ChrisOakes94/Nixie-Tube-Clock/Electrical/Nixie Tube Control Board/Other/Schematic.pdf

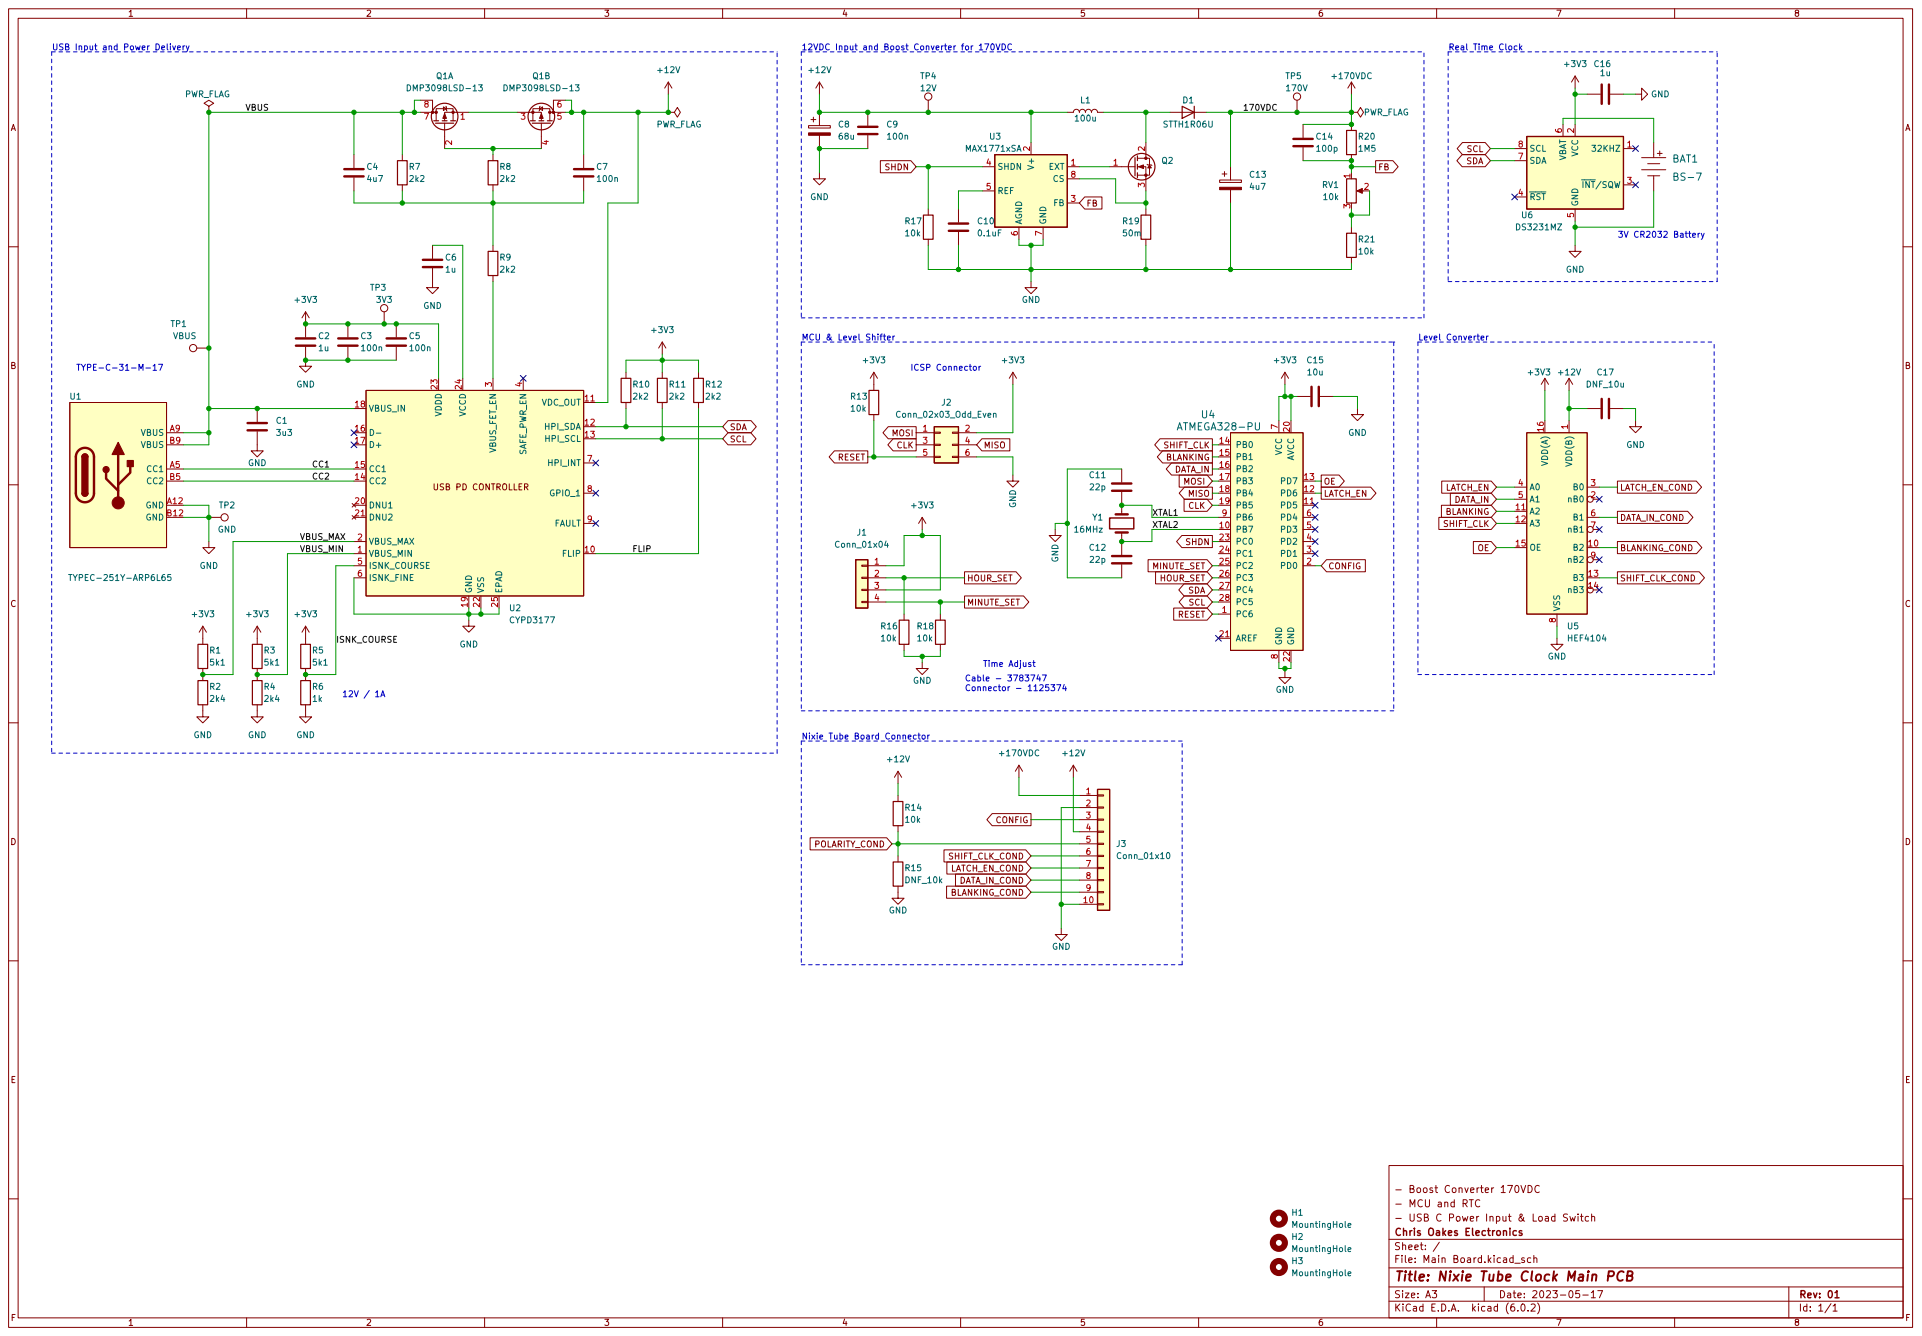
[picture p1: page 1]

2 ~{INT}/SQW 3 ~{RST} 4 GND

2 FB 3 SHDN 4 REF 5 AGND

- Boost Converter 170VDC
- MCU and RTC
- USB C Power Input & Load Switch
File: Main Board.kicad_sch Sheet: / Chris Oakes Electronics

Id: 1/1 Title: Nixie Tube Clock Main PCB
