ChrisOakes94/Nixie-Tube-Clock/Electrical/Nixie Tube Interface Board/Other/Schematic.pdf

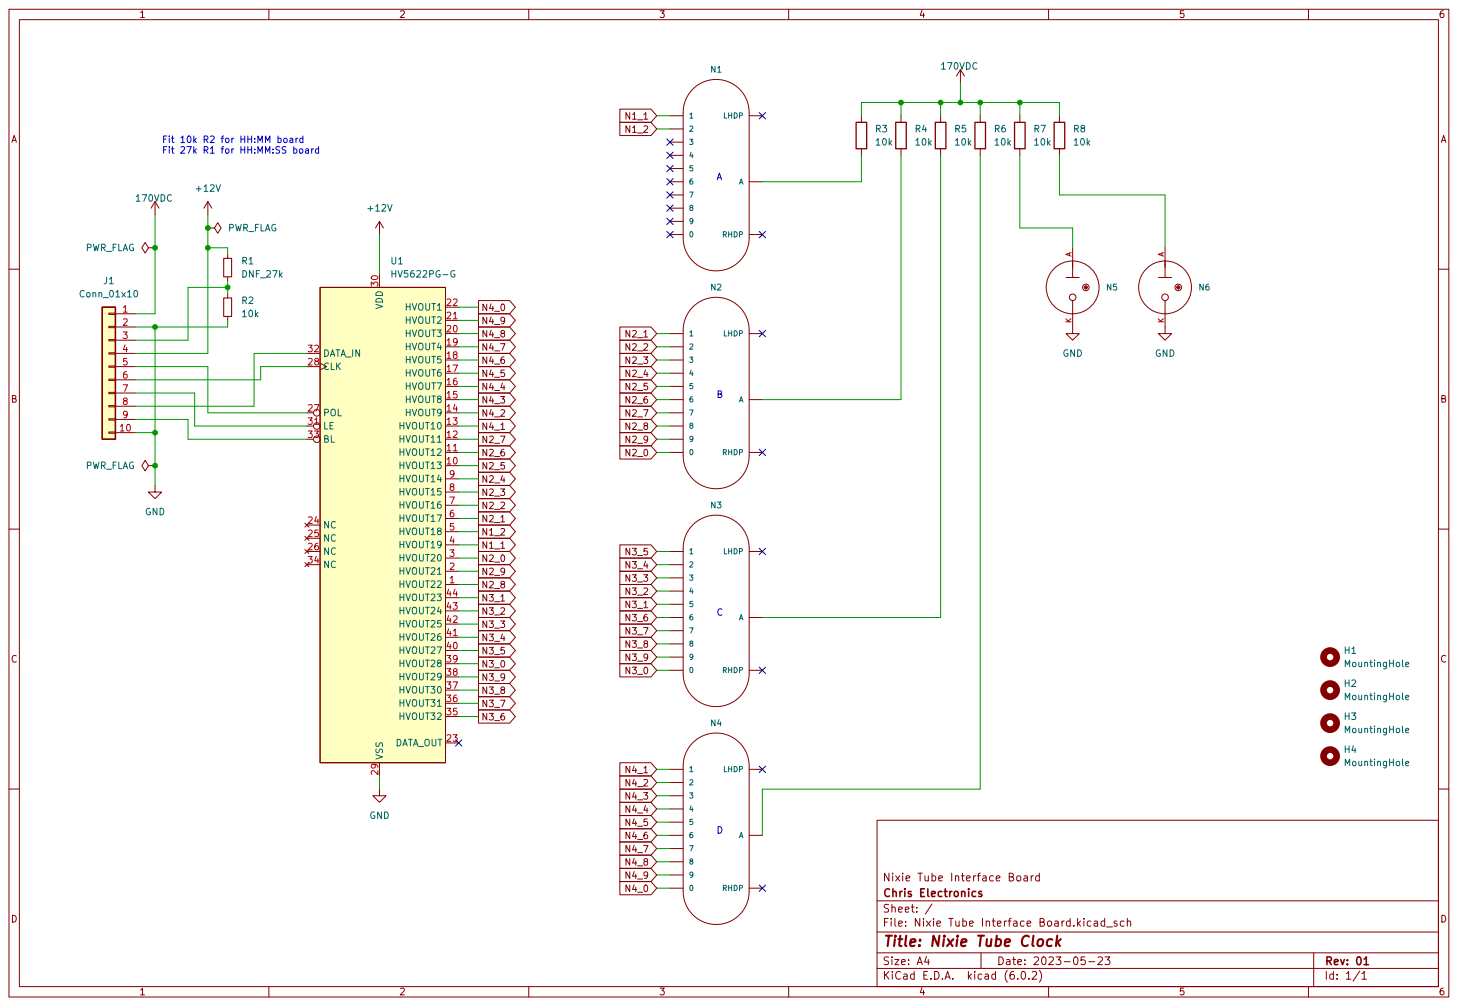
[picture p2: page 1]

Fit 10k R2 for HH:MM board Fit 27k R1 for HH:MM:SS board

Id: 1/1 Title: Nixie Tube Clock
