ChrisOakes94/Nixie-Tube-Clock/Electrical/Nixie Tube Control Board/Other/Drawing.pdf

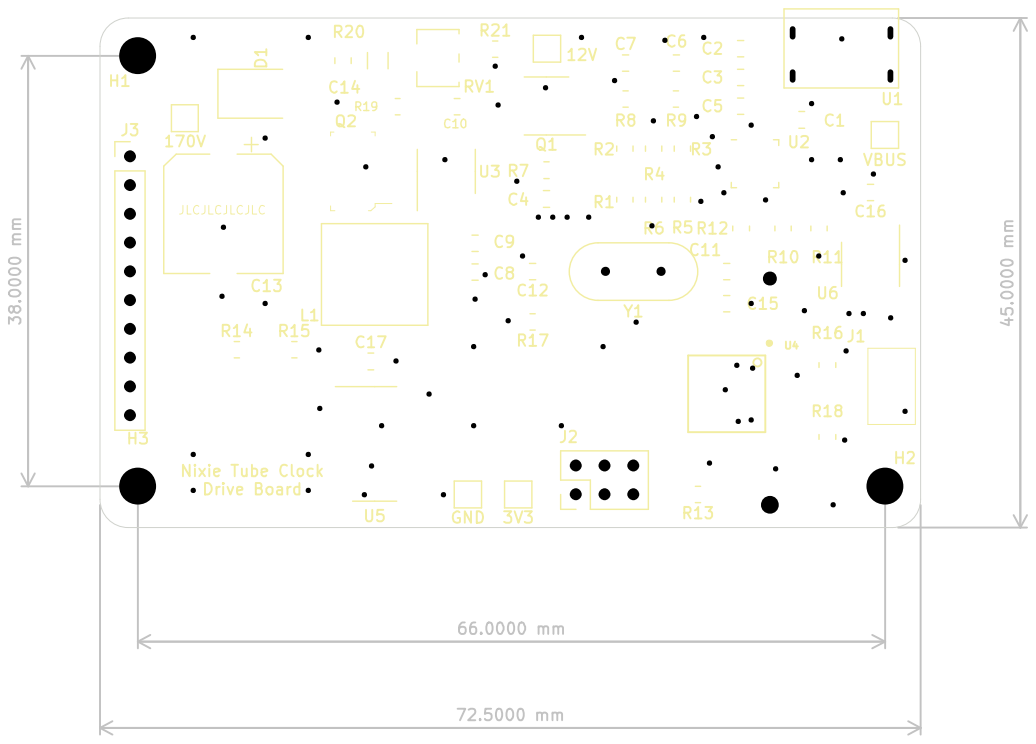
[picture p3: page 1]
