ChrisOakes94/Nixie-Tube-Clock/Electrical/Nixie Tube Interface Board/Other/Drawing.pdf

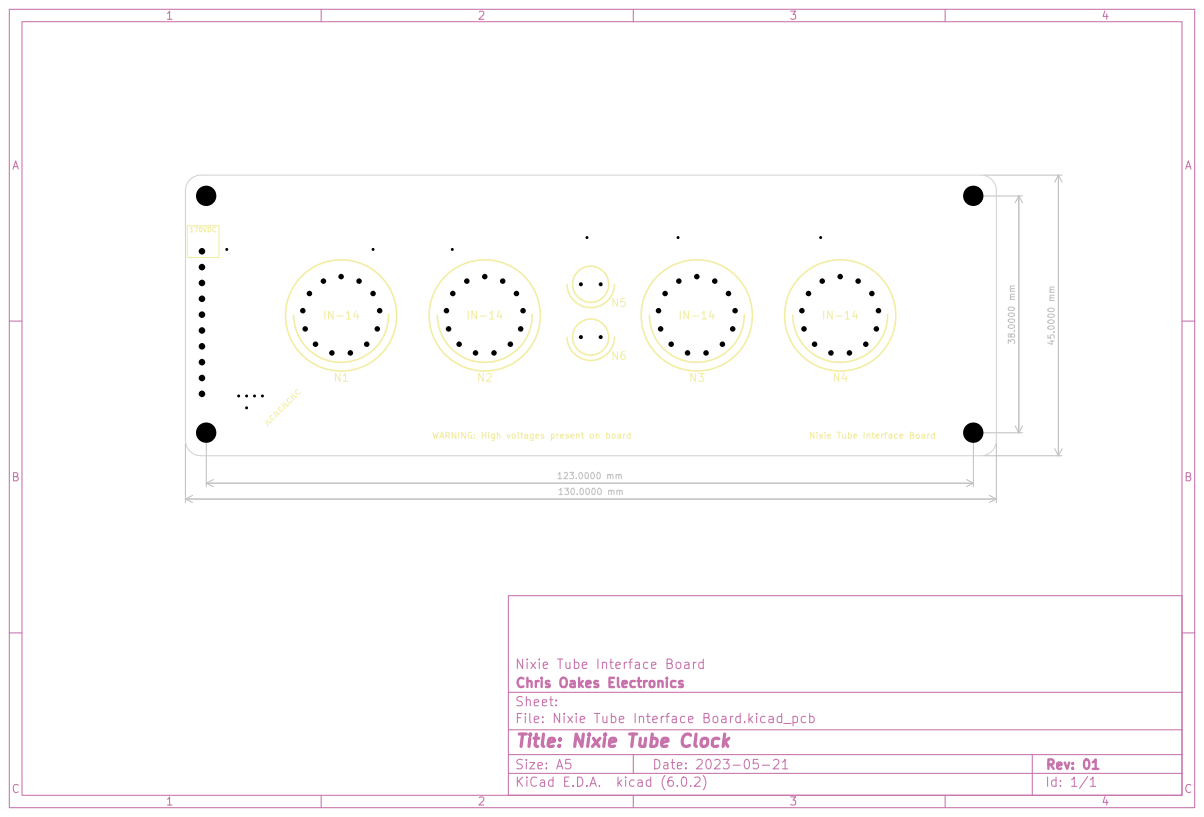
[picture p4: page 1]
