ChrisOakes94/Nixie-Tube-Clock/Electrical/Nixie Tube Interface Board/Nixie Tube Interface Board.kicad_pcb

## KiCad design Electrical/Nixie Tube Interface Board/Nixie Tube Interface Board.kicad_pcb (2023-05-26)

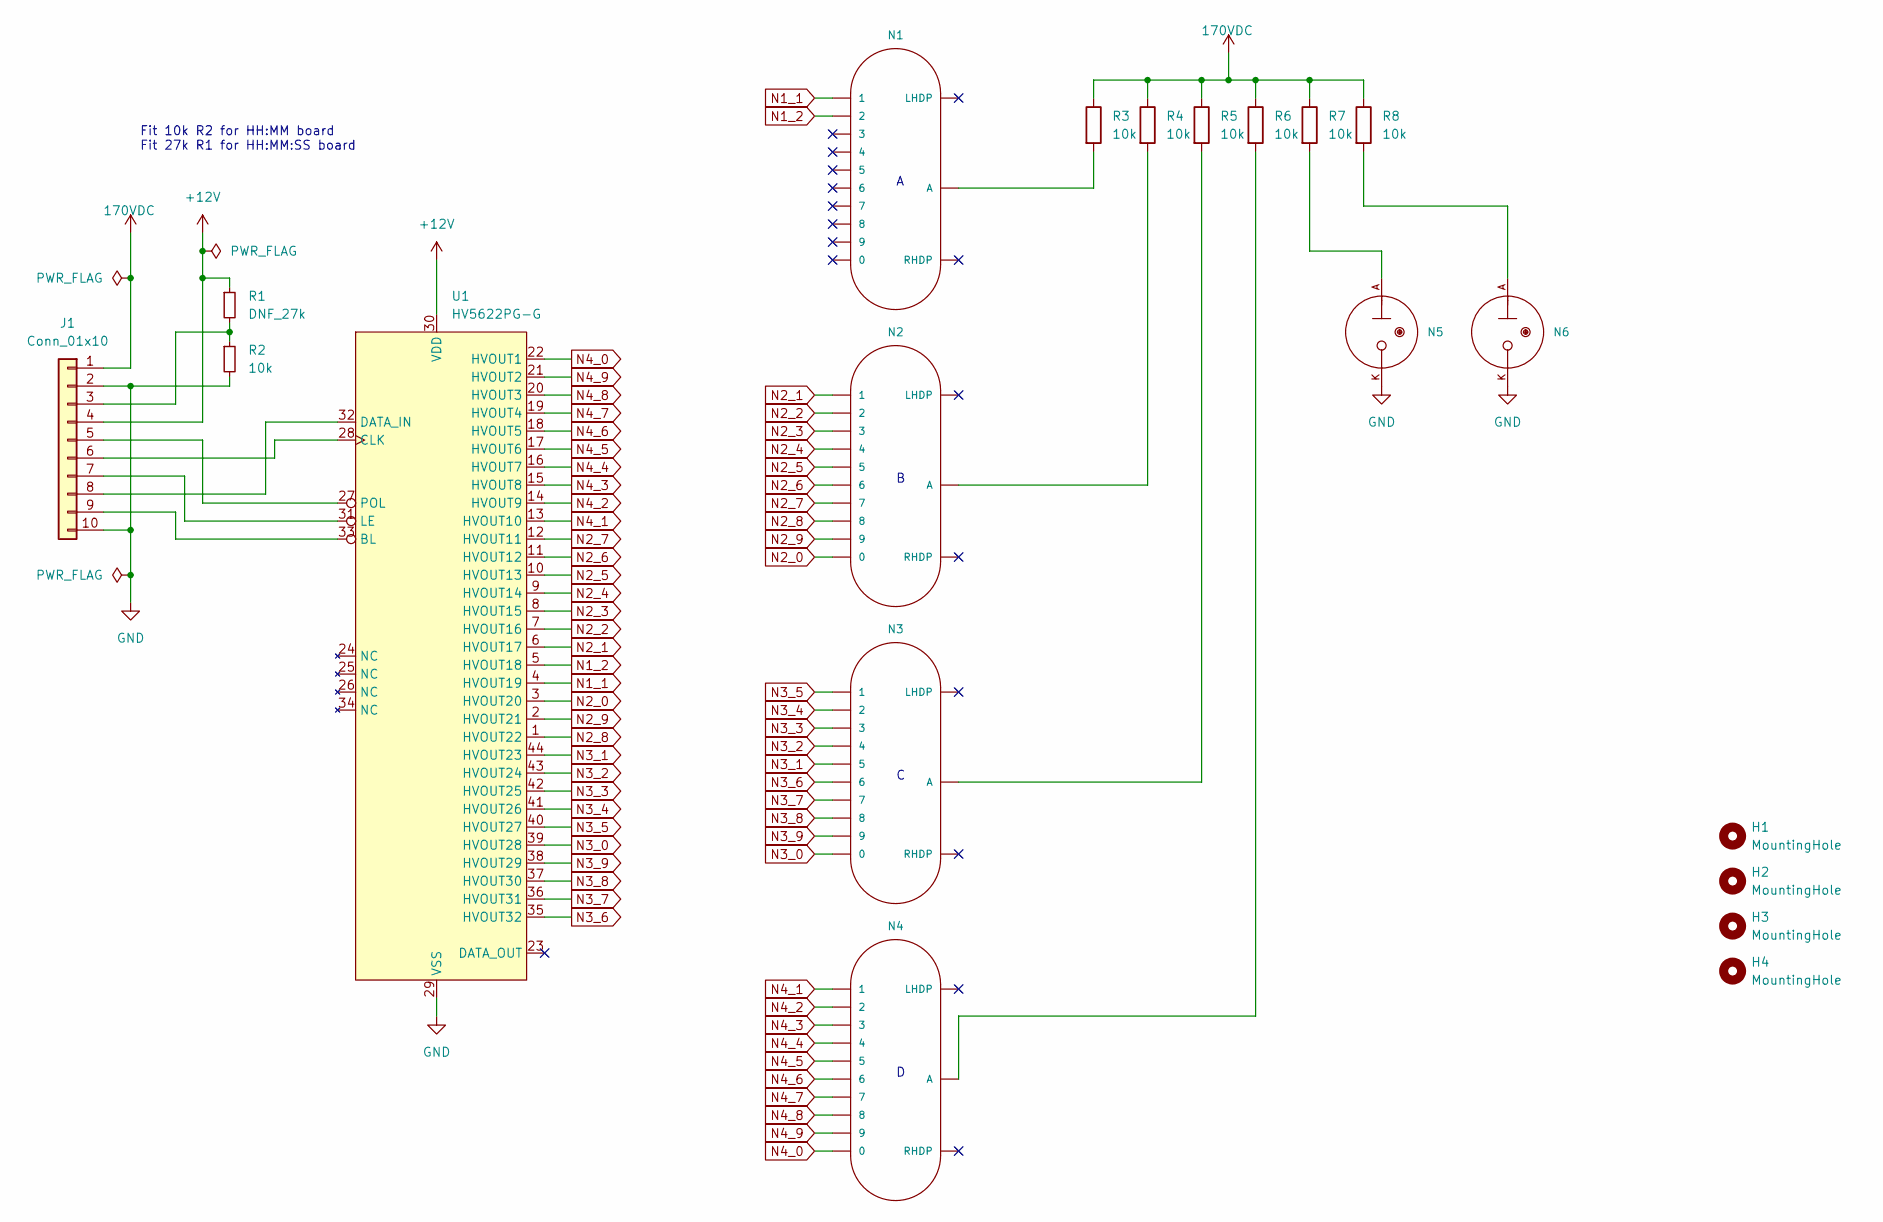
[picture p5: schematic Nixie Tube Interface Board.kicad_sch, Nixie Tube Clock]

Parts:
H1, H2, H3, H4: MountingHole; MountingHole_3.2mm_M3
J1: Conn_01x10; PinSocket_1x10_P2.54mm_Vertical
N1, N2, N3, N4: IN-14; nixies-us-IN-14
N5, N6: IN-3; nixies-us-IN-3
R1: DNF_27k; R_1206_3216Metric_Pad1.30x1.75mm_HandSolder
R2, R3, R4, R5, R6, R7, R8: 10k; R_1206_3216Metric_Pad1.30x1.75mm_HandSolder
U1: HV5622PG-G; LQFP-44_10x10mm_P0.8mm

Connections:
+12V: J1.4, R1.1, U1.30 (VDD)
+170VDC: J1.1, R3.1, R4.1, R5.1, R6.1, R7.1, R8.1
GND: J1.2, J1.10, N5.K, N6.K, R2.2, U1.29 (VSS)
N1_1: N1.1, U1.4 (HVOUT19)
N1_2: N1.2, U1.5 (HVOUT18)
N2_0: N2.0, U1.3 (HVOUT20)
N2_1: N2.1, U1.6 (HVOUT17)
N2_2: N2.2, U1.7 (HVOUT16)
N2_3: N2.3, U1.8 (HVOUT15)
N2_4: N2.4, U1.9 (HVOUT14)
N2_5: N2.5, U1.10 (HVOUT13)
N2_6: N2.6, U1.11 (HVOUT12)
N2_7: N2.7, U1.12 (HVOUT11)
N2_8: N2.8, U1.1 (HVOUT22)
N2_9: N2.9, U1.2 (HVOUT21)
N3_0: N3.0, U1.39 (HVOUT28)
N3_1: N3.5, U1.44 (HVOUT23)
N3_2: N3.4, U1.43 (HVOUT24)
N3_3: N3.3, U1.42 (HVOUT25)
N3_4: N3.2, U1.41 (HVOUT26)
N3_5: N3.1, U1.40 (HVOUT27)
N3_6: N3.6, U1.35 (HVOUT32)
N3_7: N3.7, U1.36 (HVOUT31)
N3_8: N3.8, U1.37 (HVOUT30)
N3_9: N3.9, U1.38 (HVOUT29)
N4_0: N4.0, U1.22 (HVOUT1)
N4_1: N4.1, U1.13 (HVOUT10)
N4_2: N4.2, U1.14 (HVOUT9)
N4_3: N4.3, U1.15 (HVOUT8)
N4_4: N4.4, U1.16 (HVOUT7)
N4_5: N4.5, U1.17 (HVOUT6)
N4_6: N4.6, U1.18 (HVOUT5)
N4_7: N4.7, U1.19 (HVOUT4)
N4_8: N4.8, U1.20 (HVOUT3)
N4_9: N4.9, U1.21 (HVOUT2)
unnamed: J1.3, R1.2, R2.1
unnamed: J1.5, U1.27 (POL)
unnamed: J1.6, U1.28 (CLK)
unnamed: J1.7, U1.31 (LE)
unnamed: J1.8, U1.32 (DATA_IN)
unnamed: J1.9, U1.33 (BL)
unnamed: N1.A, R3.2
unnamed: N2.A, R4.2
unnamed: N3.A, R5.2
unnamed: N4.A, R6.2
unnamed: N5.A, R7.2
unnamed: N6.A, R8.2

Notes on the sheet:
Fit 10k R2 for HH:MM board Fit 27k R1 for HH:MM:SS board

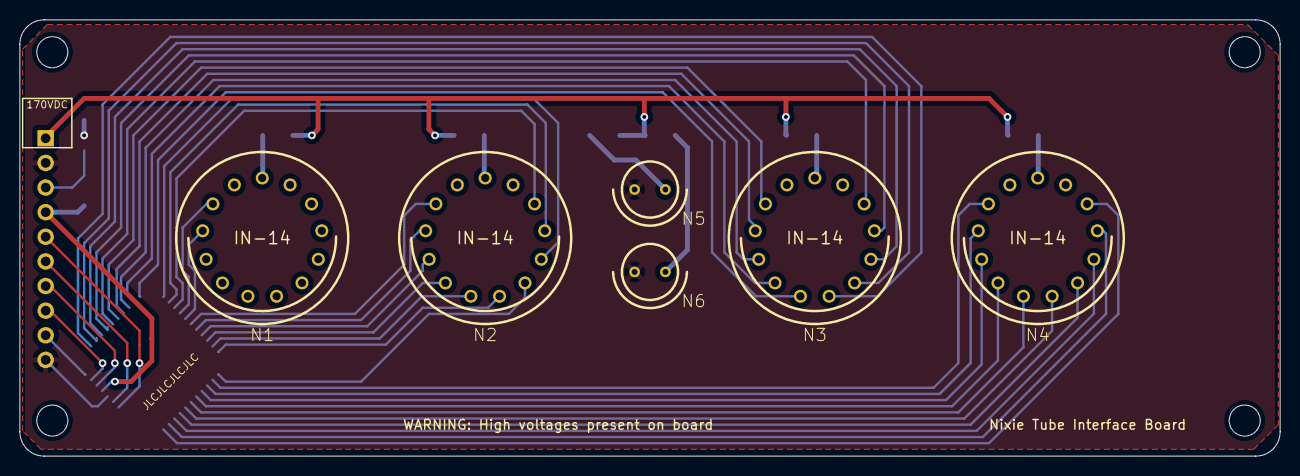
[picture p6: board Nixie Tube Interface Board.kicad_pcb from above]

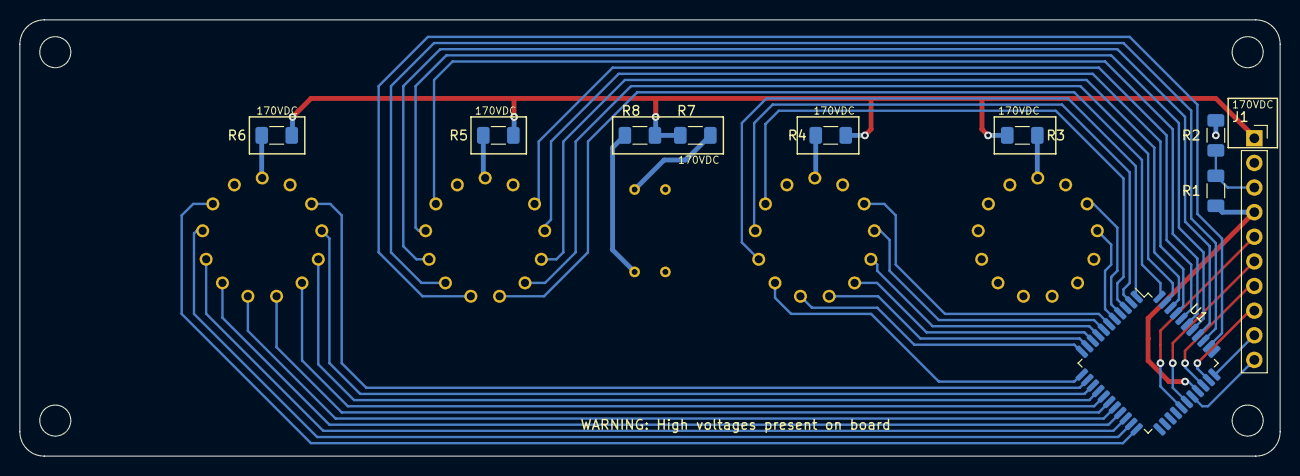
[picture p7: board Nixie Tube Interface Board.kicad_pcb from below]

Board: 2 copper layers, 130.0 x 45.0 mm, 20 parts (10 on the bottom side), 47 nets.
