ChrisOakes94/Nixie-Tube-Clock/Electrical/Nixie Tube Control Board/Main Board.kicad_pcb

## KiCad design Electrical/Nixie Tube Control Board/Main Board.kicad_pcb (2023-05-26)

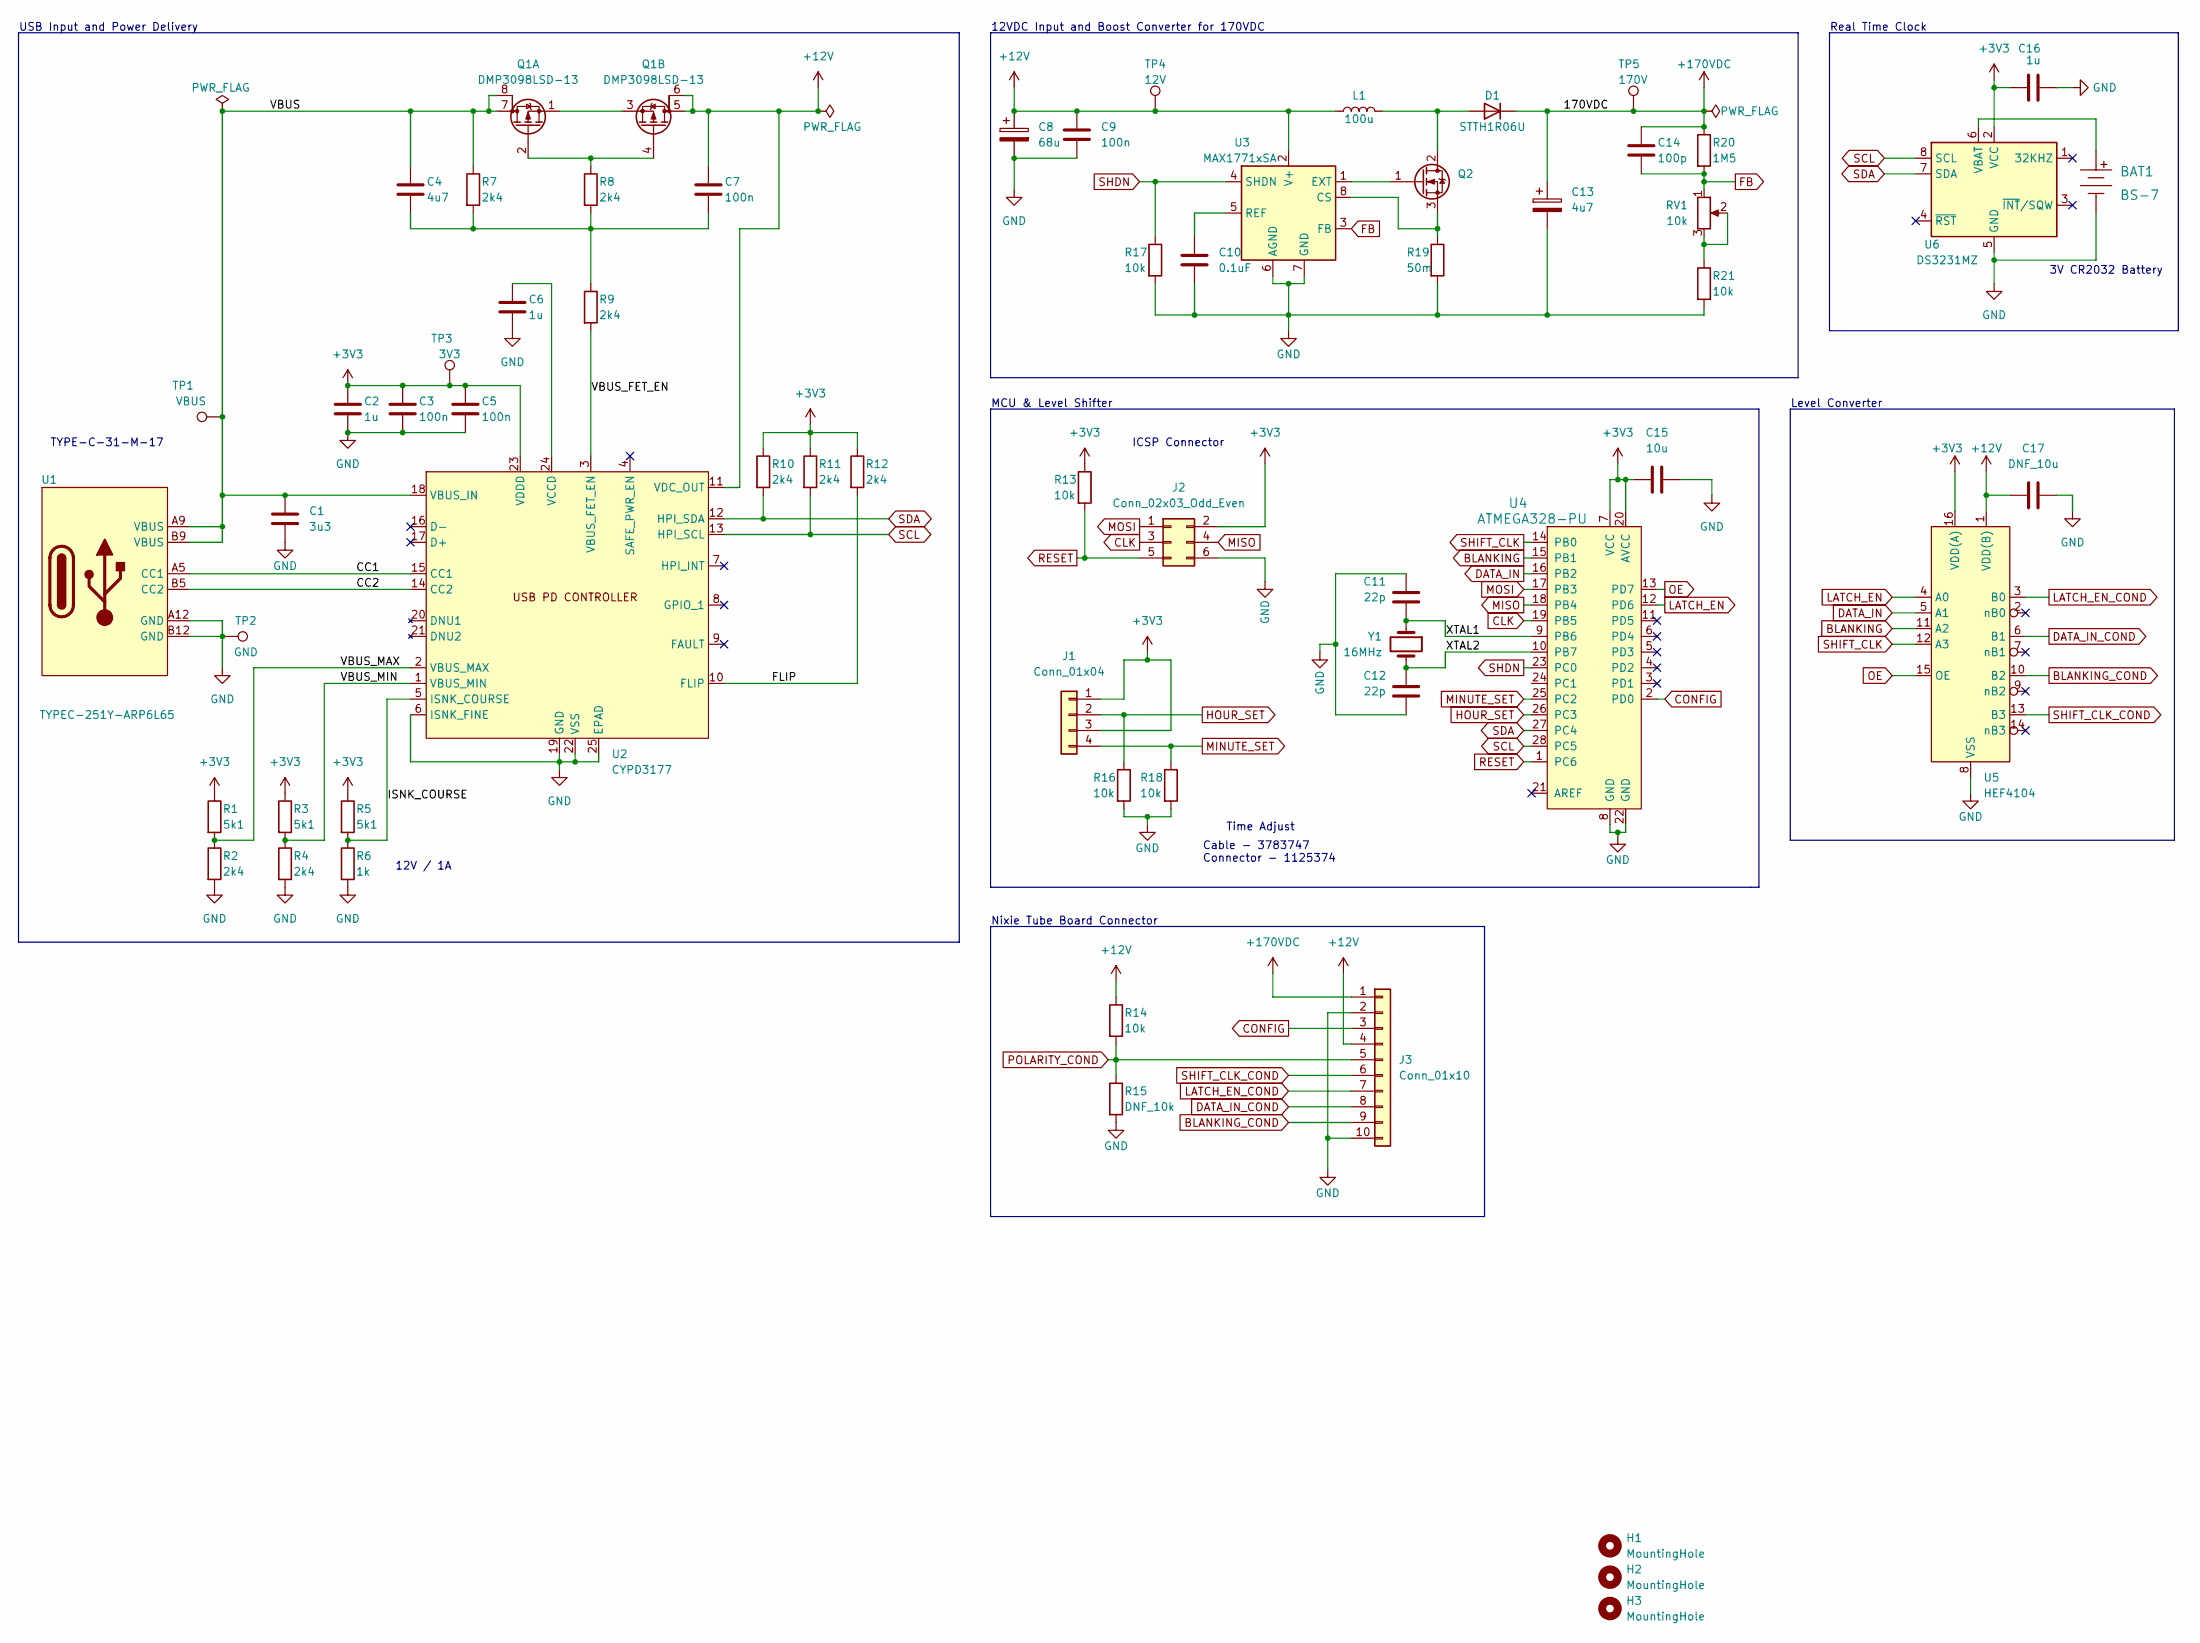
[picture p8: schematic Main Board.kicad_sch, Nixie Tube Clock Main PCB]

Parts:
BAT1: BS-7; Battery_Holder_Coin_2032_BS-7; MPN BS-7; Digi-Key_PN BS-7-ND
C1: 3u3; C_0805_2012Metric
C2, C6, C16: 1u; C_0805_2012Metric
C3, C5, C7, C9: 100n; C_0805_2012Metric
C4: 4u7; C_0805_2012Metric
C8: 68u; C_0805_2012Metric
C10: 0.1uF; C_0805_2012Metric
C11, C12: 22p; C_0805_2012Metric
C13: 4u7; CP_Elec_10x7.7; JLC P/N C2982253
C14: 100p; C_0805_2012Metric
C15: 10u; C_0805_2012Metric
C17: DNF_10u; C_0805_2012Metric
D1: STTH1R06U; D_SMB
H1, H2, H3: MountingHole; MountingHole_3.2mm_M3
J1: Conn_01x04; Molex 52361-0471
J2: Conn_02x03_Odd_Even; PinHeader_2x03_P2.54mm_Vertical
J3: Conn_01x10; PinHeader_1x10_P2.54mm_Vertical
L1: 100u; ETQP5M101YGK
Q1: DMP3098LSD-13; SOIC-8_3.9x4.9mm_P1.27mm
Q2: IPN70R600P7S; SOT-223-3
R1, R3, R5: 5k1; R_0805_2012Metric
R2, R4, R7, R8, R9, R10, R11, R12: 2k4; R_0805_2012Metric
R6: 1k; R_0805_2012Metric
R13, R14, R16, R17, R18, R21: 10k; R_0805_2012Metric
R15: DNF_10k; R_0805_2012Metric
R19: 50m; R_0805_2012Metric
R20: 1M5; R_1206_3216Metric
RV1: 10k; Potentiometer_Bourns_3214W_Vertical
TP1: VBUS; TestPoint_Pad_2.0x2.0mm
TP2: GND; TestPoint_Pad_2.0x2.0mm
TP3: 3V3; TestPoint_Pad_2.0x2.0mm
TP4: 12V; TestPoint_Pad_2.0x2.0mm
TP5: 170V; TestPoint_Pad_2.0x2.0mm
U1: TYPEC-251Y-ARP6L65
U2: CYPD3177; QFN-24-1EP_4x4mm_P0.5mm_EP2.6x2.6mm
U3: MAX1771xSA; SO-8_3.9x4.9mm_P1.27mm
U4: ATMEGA328-PU; QFP80P900X900X120-32N; MPN ATMEGA328-PU; Digi-Key_PN ATMEGA328-PU-ND
U5: HEF4104; SO-16_3.9x9.9mm_P1.27mm
U6: DS3231MZ; SOIC-8_3.9x4.9mm_P1.27mm
Y1: 16MHz; Crystal_HC49-U_Vertical

Connections:
+3V3: C2.1, C3.1, C5.1, C15.1, C16.1, J1.1, J1.3, J2.2, R1.1, R3.1, R5.1, R10.1, R11.1, R12.1, R13.1, TP3.1, U2.23 (VDDD), U4.7 (VCC), U4.20 (AVCC), U5.16 (VDD(A)), U6.2 (VCC)
+12V: C7.1, C8.1, C9.2, C17.1, J3.4, L1.1, Q1.5 (D), Q1.6 (G), R14.1, TP4.1, U2.11 (VDC_OUT), U3.2 (V+), U5.1 (VDD(B))
+170VDC: C13.1, C14.1, D1.1 (K), J3.1, R20.1, TP5.1
/CC1: U1.A5 (CC1), U2.15 (CC1)
/CC2: U1.B5 (CC2), U2.14 (CC2)
/FLIP: R12.2, U2.10 (FLIP)
/ISNK_COURSE: R5.2, R6.1, U2.5 (ISNK_COURSE)
/VBUS: C1.1, C4.1, Q1.7 (D), Q1.8 (G), R7.1, TP1.1, U1.A9 (VBUS), U1.B9 (VBUS), U2.18 (VBUS_IN)
/VBUS_FET_EN: R9.2, U2.3 (VBUS_FET_EN)
/VBUS_MAX: R1.2, R2.1, U2.2 (VBUS_MAX)
/VBUS_MIN: R3.2, R4.1, U2.1 (VBUS_MIN)
/XTAL1: C11.2, U4.9 (PB6), Y1.1
/XTAL2: C12.1, U4.10 (PB7), Y1.2
BLANKING: U4.15 (PB1), U5.11 (A2)
BLANKING_COND: J3.9, U5.10 (B2)
CLK: J2.3, U4.19 (PB5)
CONFIG: J3.3, U4.2 (PD0)
DATA_IN: U4.16 (PB2), U5.5 (A1)
DATA_IN_COND: J3.8, U5.6 (B1)
FB: C14.2, R20.2, RV1.1, U3.3 (FB)
GND: BAT1.Neg, C1.2, C2.2, C3.2, C5.2, C6.2, C8.2, C9.1, C10.2, C11.1, C12.2, C13.2, C15.2, C16.2, C17.2, J2.6, J3.2, J3.10, R2.2, R4.2, R6.2, R15.2, R16.2, R17.2, R18.2, R19.2, R21.2, TP2.1, U1.A12 (GND), U1.B12 (GND), U2.6 (ISNK_FINE), U2.19 (GND), U2.22 (VSS), U2.25 (EPAD), U3.6 (AGND), U3.7 (GND), U4.8 (GND), U4.22 (GND), U5.8 (VSS), U6.5 (GND)
HOUR_SET: J1.2, R16.1, U4.26 (PC3)
LATCH_EN: U4.12 (PD6), U5.4 (A0)
LATCH_EN_COND: J3.7, U5.3 (B0)
MINUTE_SET: J1.4, R18.1, U4.25 (PC2)
MISO: J2.4, U4.18 (PB4)
MOSI: J2.1, U4.17 (PB3)
unnamed: BAT1.Pos, U6.6 (VBAT)
unnamed: C4.2, C7.2, R7.2, R8.2, R9.1
unnamed: C6.1, U2.24 (VCCD)
unnamed: C10.1, U3.5 (REF)
unnamed: D1.2 (A), L1.2, Q2.2 (D)
unnamed: Q1.1 (S), Q1.3 (S)
unnamed: Q1.2 (G), Q1.4 (G), R8.1
unnamed: Q2.1 (G), U3.1 (EXT)
unnamed: Q2.3 (S), R19.1, U3.8 (CS)
unnamed: R21.1, RV1.2, RV1.3
OE: U4.13 (PD7), U5.15 (OE)
POLARITY_COND: J3.5, R14.2, R15.1
RESET: J2.5, R13.2, U4.1 (PC6)
SCL: R11.2, U2.13 (HPI_SCL), U4.28 (PC5), U6.8 (SCL)
SDA: R10.2, U2.12 (HPI_SDA), U4.27 (PC4), U6.7 (SDA)
SHDN: R17.1, U3.4 (SHDN), U4.23 (PC0)
SHIFT_CLK: U4.14 (PB0), U5.12 (A3)
SHIFT_CLK_COND: J3.6, U5.13 (B3)

Notes on the sheet:
Level Converter
Real Time Clock
MCU & Level Shifter
Time Adjust
12VDC Input and Boost Converter for 170VDC
TYPE-C-31-M-17
ICSP Connector
Cable - 3783747 Connector - 1125374
3V CR2032 Battery
USB Input and Power Delivery
12V / 1A
Nixie Tube Board Connector

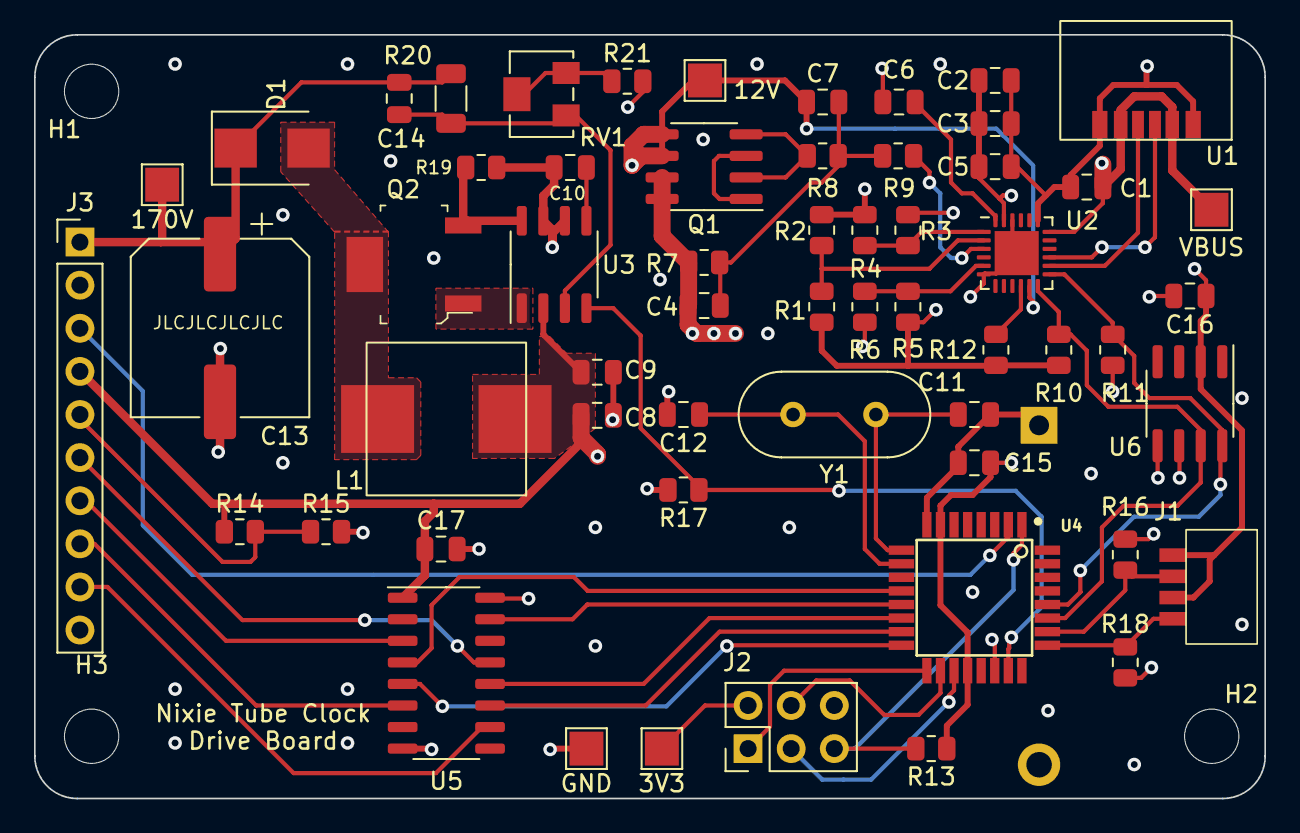
[picture p9: board Main Board.kicad_pcb from above]

Board: 4 copper layers, 72.5 x 45.0 mm, 62 parts (1 on the bottom side), 45 nets.
